giovane-sylvestrin/BMS_grs/Layout placa principal.pdf

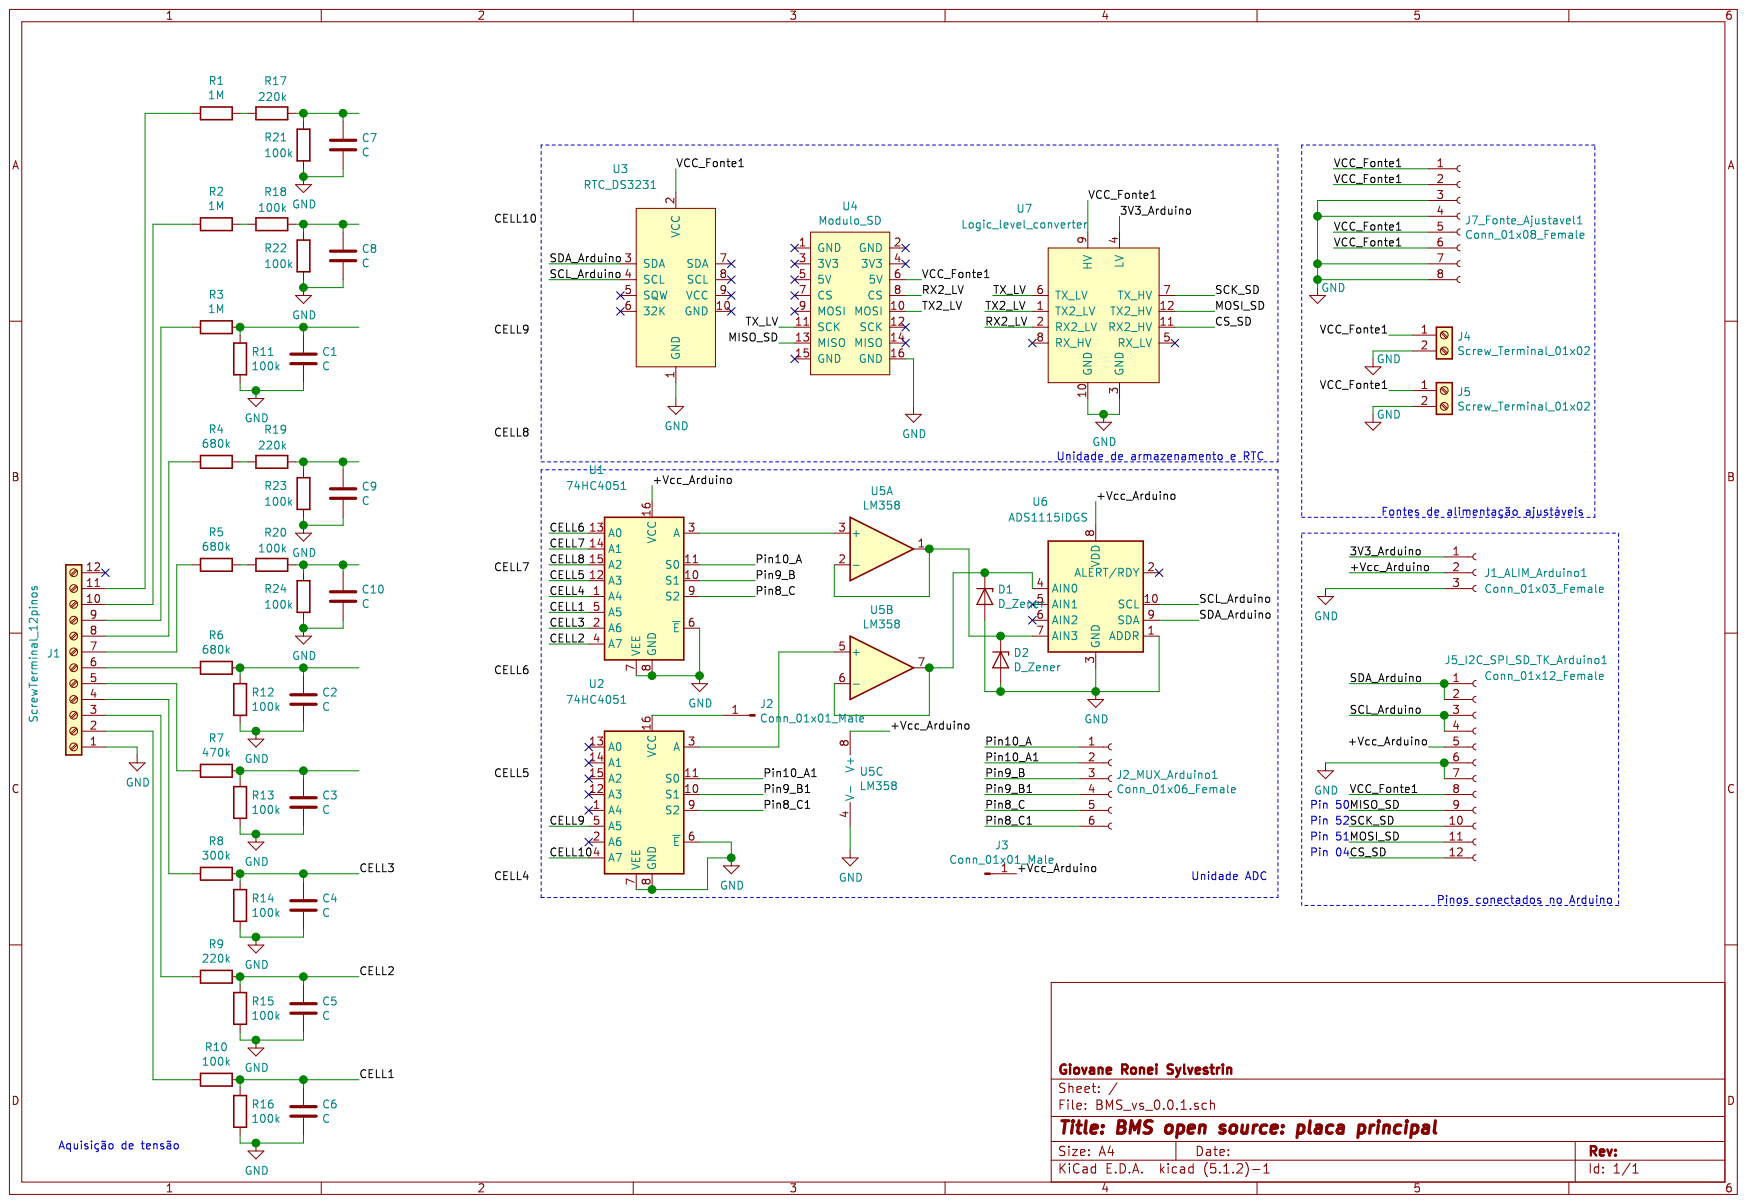
[picture p1: page 1]
