giovane-sylvestrin/BMS_grs/Layout placa temperatura.pdf

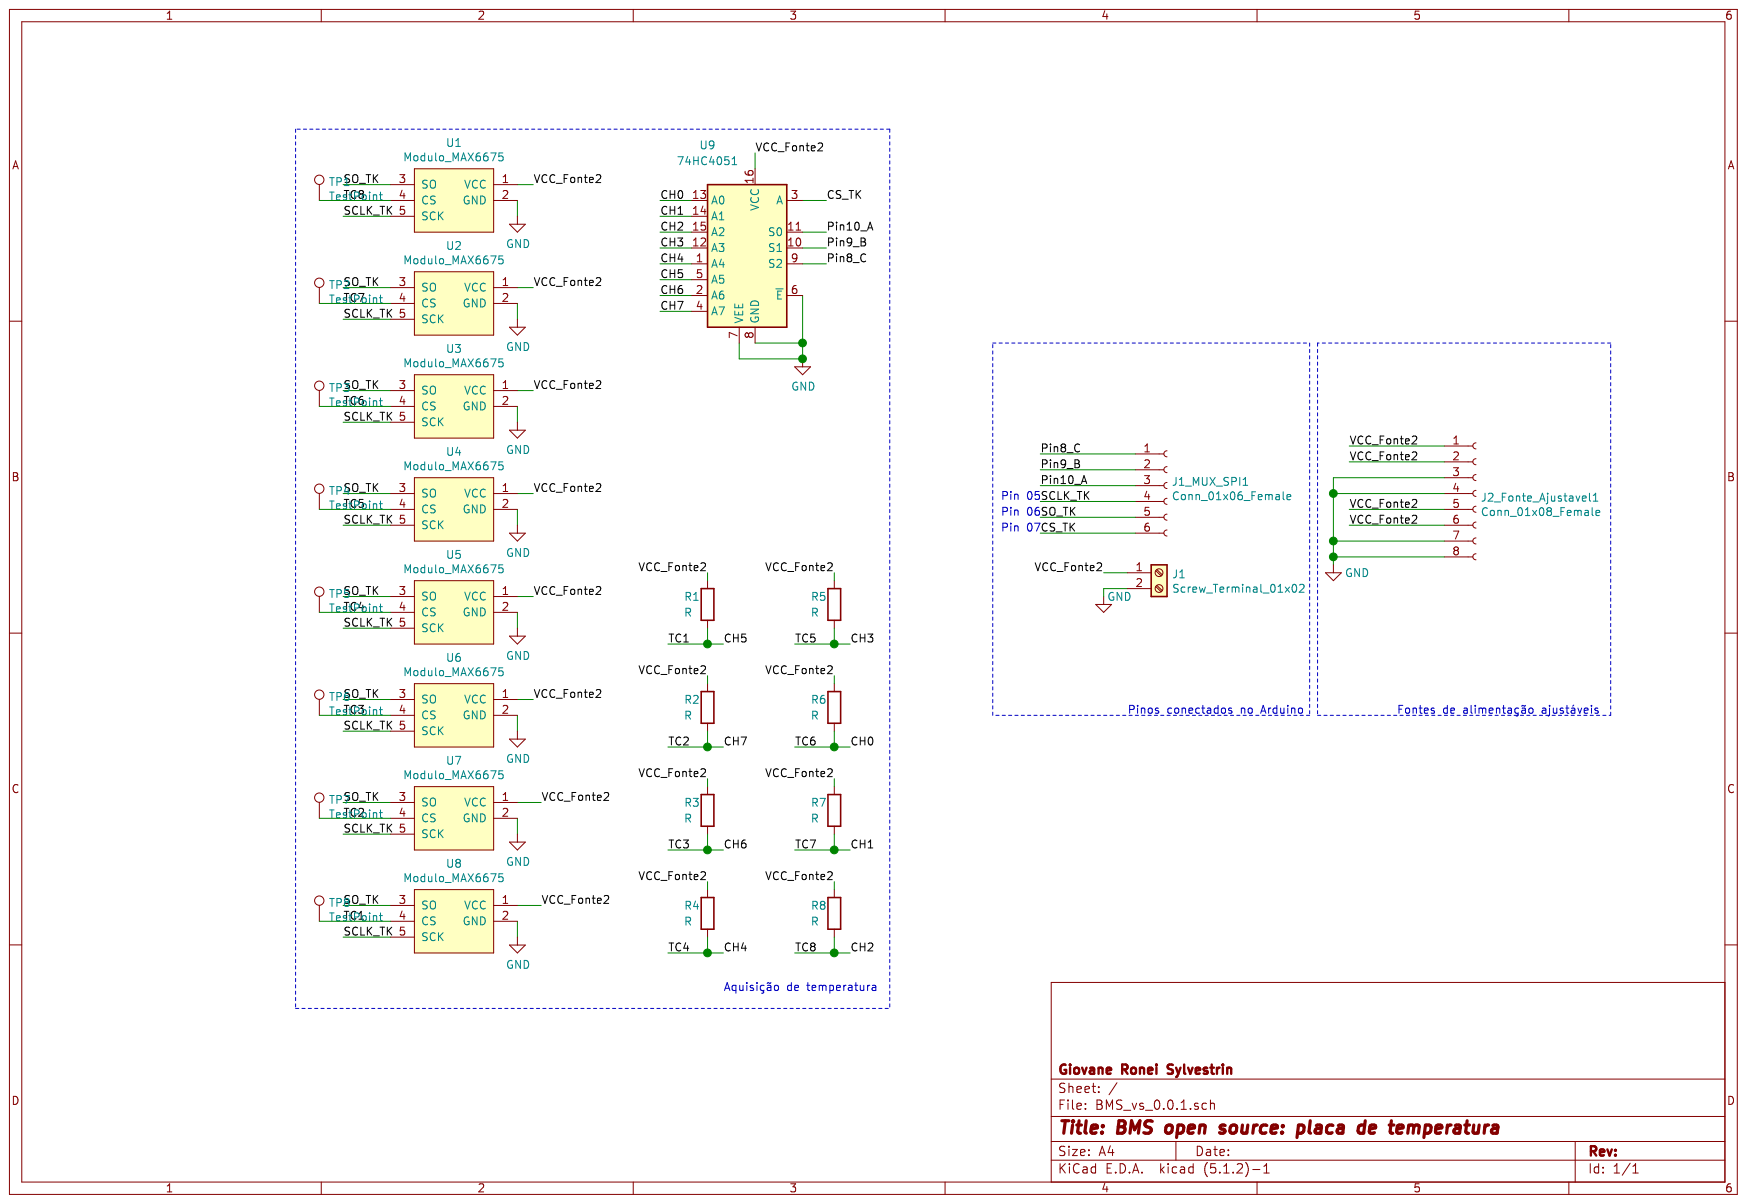
[picture p2: page 1]
