giovane-sylvestrin/BMS_grs/Algoritmos/apendice_sodio1AB/apendice_sodio1AB.ino

#include <Wire.h>  //Biblioteca para comunicação I2C
#include <DS3232RTC.h>  //Biblioteca RTC DS3231
#include <Streaming.h>  //Biblioteca para impressão de variáveis
#include <Time.h> //Biblioteca relacionada à manipulação de tempo
#include <SD.h> //Biblioteca para escrita e leitura cartão SD
#include <SPI.h>  //Biblioteca para comunicação SPI
#include <Adafruit_ADS1015.h> //Biblioteca para uso do ADC ADS1115

Adafruit_ADS1115 ads(0x48); //Endereçamento I2C do ADC para leitura dos canais de tensão
Adafruit_ADS1115 ads1(0x49); //Endereçamento I2C do ADC para leitura do sinal do ACS712

const int CS_PIN = 4; //Declaração do pino CS (chip select - SPI) no módulo SD

File file;  //Define "file" como comando para gravação de dados no cartão SD

//Definição dos pinos para manipulação do MUX nos canais de aquisição de tensão
int s0 = 10;
int s1 = 9;
int s2 = 8;

//Vetores de aquisição de tensão, tamanho do vetor indica número de canais habilitados
double AIN[8];
double v_lido[8];                              
double v_p[8];
double v_cell[8];

//Vaiáveis para aquisição de corrente
float corrente = 0;
float acs = 0;

//---------------- Temperatura ------------------------------------------------
const int SO = 6; //Definição pino MISO - Master Input, Slave Output - Para MAX6675
const int SCLK = 7; //Definição pino SCLK - Serial Clock line - Para MAX6675
const int CS1 = 5;  //Definição pino CS - Chip Select - Para MAX6675

double Temp[8]; //Vetor para aquisição de temperatura, tamanho do vetor indica número de canais habilitados 

//Definição dos pinos para manipulação do DEMUX nos canais de aquisição de temperatura
int A_t = 13;
int B_t = 12;
int C_t = 11;

byte SPImax(); //Declaração da função de comunicação SPI com MAX6675 por software
double leitura_termopar(int Selecao);

//-----------------------------------------------------------------------------

int intervalo = 2; //Tempo (em s) de amostragem das medidas (2s - 1 cell, 10 - multi)
int cont = 0; //Contador de amostras de medidas

int pausa = 5; //Pausa em us para alteração do canal do MUX/DEMUX

//----- Declaração variáveis SOC: EKF, contagem de Coulomb, e contagem modificada --------
float v_0; //Variável que recebe o valor de tensão do canal 1 (EKF aplicado)
float x_prevA = 0; //Estimação prévia do SOC Proposta A
float x_prevB = 0; //Estimação prévia do SOC Proposta B
float x_prev = 0;
float R_in = 0; //Resistência interna
float t_0 = 0;  //Variável para contagem de de tempo
float t_end = 0;  //Variável para contagem de de tempo
float t_end1 = 0; //Variável para contagem de de tempo
float x_0A = 100;  //Definição do SOC inicial e variável auxiliar na estimação SOC Proposta A
float x_0B = 100;  //Definição do SOC inicial e variável auxiliar na estimação SOC Proposta A
float ocv = 0;  //Tensão de circuito aberto
float C = 0;  //Parâmetro relacionado a mtriz jacobiana EKF (Eq. 4.14)
float C1 = 0; //Variável auxiliar para cálculo de C
float C2 = 0; //Variável auxiliar para cálculo de C
float Q = 0.001;  //Covariância associada ao ruído de estado
float R = 0.001;  //Covariância associada ao ruído do sensor
float L = 0;  //Ganho de Kalman
float P_prevA = 0; //Covariância do erro de estimação prévia Proposta A
float P_prevB = 0; //Covariância do erro de estimação prévia Proposta B
float P_0A = 10000; //Covariância do erro de estimação inicial e atualizado
float P_0B = 10000; //Covariância do erro de estimação inicial e atualizado
float y_prevA = 0; //Tensão terminal estimada Proposta A
float y_prevB = 0; //Tensão terminal estimada Proposta B
float x_posA = 0;  //SOC estimado atualizado Proposta A
float x_posB = 0;  //SOC estimado atualizado Proposta B
float x_posmxA = 0;  //Limite superior de estimação SOC (intervalo de confiança) Proposta A
float x_posmxB = 0;  //Limite superior de estimação SOC (intervalo de confiança) Proposta B
float x_posmiA = 0;  //Limite inferior de estimação SOC (intervalo de confiança) Proposta A
float x_posmiB = 0;  //Limite inferior de estimação SOC (intervalo de confiança) Proposta B
float x_cc = 100; //Definição do SOC inicial para a estimação por contagem de Coulomb
int s = 0;  //Define sinal da corrente (carga ou descarga)
int st = 0; //Define atualização na contagem de capacidade de carga(DODc) e descarga (DOD)
int estado = 1; //Define condição de uso do EKF na proposta A
int ref = 0;  //Variável auxiliar de contagem da proposta B
float DOD = 0; //Capacidade de descarga em Ah
float DODc = 0; //Capacidade de carga em Ah
//----------------------------------------------------------------------------------------

//Função de declaração e inicialização (função padrão Arduino)
void setup(){
 
 //Define os pinos de manipulação MUX/DEMUX como saída
 pinMode(s0,OUTPUT);
 pinMode(s1,OUTPUT);
 pinMode(s2,OUTPUT);
 pinMode(A_t,OUTPUT);
 pinMode(B_t,OUTPUT);
 pinMode(C_t,OUTPUT);

 //Define pinos relacionados ao MAX6675 como saída ou entrada 
 pinMode(CS1,OUTPUT);
 pinMode(SCLK,OUTPUT);
 pinMode(SO,INPUT);
 digitalWrite(CS1,HIGH);

 //Inicializa os vetores de medição de tensão e temperatura
 for(int i = 0; i<=7; i++){
    AIN[i] = 0;
    v_lido[i] = 0;
    Temp[i] = 0; 
 }
 
 Serial.begin(115200);  //Inicia comunicação serial na taxa de 115200 bits/segundo

 inicia_SD(); //Inicialização do módulo SD
 
 //Comando da biblioteca Time.h para executar sincronização com o RTC DS3231
 setSyncProvider(RTC.get); //RTC.get é função da biblioteca DS3231.h e retorna tempo atual
 Serial << F("RTC Sync"); //Imprime na tela confirmação de sincronização
 if (timeStatus() != timeSet) Serial << F(" FALHA!"); //Imprime na tela erro de sincronização
 Serial << endl;

  //Configuração da resolução e ganho no uso do ADS1115
  //                                                                 ADS1115
  //Ganho ADC para aquisição de tensão                               -------
  //ads.setGain(GAIN_TWOTHIRDS);   // 2/3x ganho +/- 6.144V  1 bit = 0.1875mV 
  ads.setGain(GAIN_ONE);           // 1x ganho   +/- 4.096V  1 bit = 0.125mV 
  // ads.setGain(GAIN_TWO);        // 2x ganho   +/- 2.048V  1 bit = 0.0625mV
  // ads.setGain(GAIN_FOUR);       // 4x ganho   +/- 1.024V  1 bit = 0.03125mV
  // ads.setGain(GAIN_EIGHT);      // 8x ganho   +/- 0.512V  1 bit = 0.015625mV 
  // ads.setGain(GAIN_SIXTEEN);    // 16x ganho  +/- 0.256V  1 bit = 0.0078125mV

  ads1.setGain(GAIN_TWOTHIRDS); //Ganho ADC do sensor de corrente ACS712
  
  ads.begin();  //Início da operação do ADC de aquisição de tensão
  ads1.begin(); //Início da operação do ADC do sensor ACS712

  Serial.println("Iniciando monitoramento ...");
}

//Função de repetição do Arduíno
void loop(){

  time_t t; //Variável tipo time (32 bits): número de segundos desde 1970  
  tmElements_t tm;  //Estrutura para manipulação de tempo

    //Configuração de data e hora por entrada serial
    //Formato reconhecido: ANO,MES,DIA,HORA,MINUTO,SEGUNDO
    if (Serial.available() >= 12) { //Verifica se existe alteração na data/hora via serial

        int y = Serial.parseInt();
        if (y >= 100 && y < 1000){
            Serial << F("Erro: Ano deve ter 2 ou 4 digitos") << endl;
        }else{
            if (y >= 1000)
                tm.Year = CalendarYrToTm(y);
            else
            tm.Year = y2kYearToTm(y);
            tm.Month = Serial.parseInt();
            tm.Day = Serial.parseInt();
            tm.Hour = Serial.parseInt();
            tm.Minute = Serial.parseInt();
            tm.Second = Serial.parseInt();
            t = makeTime(tm); //t recebe a data e hora da estrutura tm em segundos
            RTC.set(t); //Configura a data e hora do RTC para corresponder a t
            setTime(t); //Define a hora atual baseada em t
            Serial << F("RTC configurado para: ");
            printDateTime(t); //Imprime na tela data e hora configurada
            Serial << endl;
            while (Serial.available() > 0) Serial.read(); //Ignora qualquer entrada serial distinta da desejada
        }
    }

    monitoramento(t); //Função principal de Monitoramento: tensão, corrente, temperatura e SOC
       
}

//Função para aquisição de tensão, corrente, temperatura
//Estimação SOC
//Gravação de Dados
//Comunicação Serial
void monitoramento(time_t t){

  t_0 = millis();
  
  int16_t adc3; //Variavel associada à leitura de tensão ADS1115
  time_t anterior; //Variável auxiiar no tempo de amostragem
  time_t atual; //Variável auxiliar no tempo de amostragem
  anterior = now(); //Recebe tempo atual
  atual = now();  //Recebe tempo atual

  //Laço de repetição para amostragem dos sinais de tensão, corrente e temperatura
  while(abs(atual-anterior) < intervalo)
  {
    //CÉLULA 1
    digitalWrite(s0,HIGH);
    digitalWrite(s1,LOW); //Seleção do canal do MUX CD4051
    digitalWrite(s2,HIGH);

    delayMicroseconds(pausa);
    
    adc3 = ads.readADC_SingleEnded(3);
    v_lido[0] = (adc3*0.125)/1000;
    AIN[0] = AIN[0] + v_lido[0];

    //Para habilitar demais canais de tensão, retirar comentário
    /*
    //CÉLULA 2
    digitalWrite(s0,HIGH);
    digitalWrite(s1,HIGH);
    digitalWrite(s2,HIGH);

    delayMicroseconds(pausa);
    
    adc3 = ads.readADC_SingleEnded(3);
    v_lido[1] = (adc3*0.125)/1000;
    AIN[1] = AIN[1] + v_lido[1];
    
    //CÉLULA 3
    digitalWrite(s0,LOW);
    digitalWrite(s1,HIGH);
    digitalWrite(s2,HIGH);

    delayMicroseconds(pausa);
    
    adc3 = ads.readADC_SingleEnded(3);
    v_lido[2] = (adc3*0.125)/1000;
    AIN[2] = AIN[2] + v_lido[2];
    
    //CÉLULA 4
    digitalWrite(s0,LOW);
    digitalWrite(s1,LOW);
    digitalWrite(s2,HIGH);

    delayMicroseconds(pausa);
    
    adc3 = ads.readADC_SingleEnded(3);
    v_lido[3] = (adc3*0.125)/1000;
    AIN[3] = AIN[3] + v_lido[3];

    //CÉLULA 5
    digitalWrite(s0,HIGH);
    digitalWrite(s1,HIGH);
    digitalWrite(s2,LOW);

    delayMicroseconds(pausa);
    
    adc3 = ads.readADC_SingleEnded(3);
    v_lido[4] = (adc3*0.125)/1000;
    AIN[4] = AIN[4] + v_lido[4];

    //CÉLULA 6
    digitalWrite(s0,LOW);
    digitalWrite(s1,LOW);
    digitalWrite(s2,LOW);

    delayMicroseconds(pausa);
    
    adc3 = ads.readADC_SingleEnded(3);
    v_lido[5] = (adc3*0.125)/1000;
    AIN[5] = AIN[5] + v_lido[5];

    //CÉLULA 7
    digitalWrite(s0,HIGH);
    digitalWrite(s1,LOW);
    digitalWrite(s2,LOW);

    delayMicroseconds(pausa);
    
    adc3 = ads.readADC_SingleEnded(3);
    v_lido[6] = (adc3*0.125)/1000;
    AIN[6] = AIN[6] + v_lido[6];

    //CÉLULA 8
    digitalWrite(s0,LOW);
    digitalWrite(s1,HIGH);
    digitalWrite(s2,LOW);

    delayMicroseconds(pausa);
    
    adc3 = ads.readADC_SingleEnded(3);
    v_lido[7] = (adc3*0.125)/1000;
    AIN[7] = AIN[7] + v_lido[7];

    delayMicroseconds(pausa);
    */
    
    acs = acs + ads1.readADC_SingleEnded(3); //Leitura sinal sensor de corrente ACS712
    
    //Para habilitar aquisição de temperatura, retirar comentário
    //temperatura(); //Função de aquisição de temperatura
        
    cont = cont +1;
    atual = now();
    
   }

  //Conversão do sinal de entrada do ADC para valores de tensão
  AIN[0] = AIN[0]/cont;
  v_p[0] = 2*AIN[0];

  AIN[1] = AIN[1]/cont;
  v_p[1] = 3.195*AIN[1];

  AIN[2] = AIN[2]/cont;
  v_p[2] = 4.019*AIN[2];

  AIN[3] = AIN[3]/cont;
  v_p[3] = 5.7296*AIN[3];

  AIN[4] = AIN[4]/cont;
  v_p[4] = 7.9203*AIN[4];

  AIN[5] = AIN[5]/cont;
  v_p[5] = 8.9333*AIN[5];

  AIN[6] = AIN[6]/cont;
  v_p[6] = 10.0268*AIN[6];

  AIN[7] = AIN[7]/cont;
  v_p[7] = 11.1652*AIN[7];

  //Estabelece a tensão terminal em cada canal de aquisição
  for(int i = 0; i <= 7; i++){
    if(v_p[i] < 0.1){
      v_p[i] = 0;
      v_cell[i] = 0;
    }else{
      v_cell[i] = v_p[i];
      if(i>0){
        for(int j = 0; j<i; j++){
          v_cell[i] = v_cell[i] - v_cell[j];
        }
      }
    }
  }

  //Estabelece a temperatura por canal
  for(int i = 0; i <= 7; i++){
    Temp[i] = Temp[i]/cont;
  }

  //Estabelece o valor de corrente em A
  acs = acs/cont;
  acs = (acs*0.1875)/1000;
  corrente = ((acs - 2.51)*1000)/66;

  //Define se a corrente é no sentido carga ou descarga
  if(corrente < 0)                  
  {
    s=1; //descarga
  }else{
    s=-1; //carga
  }

  //Calibração do sinal de corrente
  corrente = s*(0.96444433*abs(corrente) + 0.00092722); 
  
  if(abs(corrente)<0.2) //Descarta possíveis ruídos de medição
  {
    corrente = 0;
  }
  
  v_0 = v_cell[0];  //Tensão canal 1 habilitada para a estimativa SOC via EKF
    
  //------------------------- DESCARGA/REPOUSO -----------------------------
  if((v_0 > 1) && (corrente >= 0))
    {
      //Função responsável pela estimação do SOC na descarga via: EKF, contagem de Coulomb e contagem modificada
      EKF();
    }
  //----------------------------- CARGA ------------------------------------
  if(corrente < 0)
    {
      //Função responsável pela estimação do SOC na descarga: contagem de Coulomb
      Coulomb_carga(); 
    }
  //------------------------------------------------------------------------  
  t = now();
  //printDateTime(t); //Habilitar caso usuário não use interface Node-RED
  
  //Envio dos resultados por comunicação serial
  Serial.print("{\"V1\":");
  Serial.print(v_cell[0],4);
  Serial.print(",\"I\":");
  Serial.print(corrente,3);
  Serial.print(",\"x_posA\":");
  Serial.print(x_posA);
  Serial.print(",\"x_mxA\":");
  Serial.print(x_posmxA);
  Serial.print(",\"x_mnA\":");
  Serial.print(x_posmiA);
  Serial.print(",\"x_posB\":");
  Serial.print(x_posB);
  Serial.print(",\"x_mxB\":");
  Serial.print(x_posmxB);
  Serial.print(",\"x_mnB\":");
  Serial.print(x_posmiB);
  Serial.print(",\"x_cc\":");
  Serial.print(x_cc);
  Serial.print(",\"DOD_d\":");
  Serial.print(DOD);
  Serial.print(",\"DOD_c\":");
  Serial.print(DODc);
  Serial.print(",\"y_ekfA\":");
  Serial.print(y_prevA,4);
  Serial.print(",\"y_ekfB\":");
  Serial.print(y_prevB,4);
  Serial.print(",\"delta_t\":");
  Serial.print(abs(t_0 - t_end1));
  Serial.println("}");
  
  abre_arquivo("DADOS.txt");  //Abre (ou cria) arquivo de texto DADOS.txt no cartão SD
  
  grava_tempo(t); //Grava data e hora no cartão SD
  //Dados gravados no cartão SD
  //Dados BMS unicelular com EKF
  file.print(" ADC1: ");
  file.print(AIN[0],4);
  file.print(" Ponto A: ");
  file.print(v_p[0],4);
  file.print(" V1: ");
  file.print(v_0,4);
  file.print(" VekfA: ");
  file.print(y_prevA,4);
  file.print(" SOCA: ");
  file.print(x_posA,4);
  file.print(" ");
  file.print(x_posmxA,4);
  file.print(" ");
  file.print(x_posmiA,4);
  file.print(" VekfB: ");
  file.print(y_prevB,4);
  file.print(" SOCB: ");
  file.print(x_posB,4);
  file.print(" ");
  file.print(x_posmxB,4);
  file.print(" ");
  file.print(x_posmiB,4);
  file.print(" SOCcc: ");
  file.print(x_cc,4);
  file.print(" DODd (Ah): ");
  file.print(DOD);
  file.print(" DODc (Ah): ");
  file.print(DODc);
  file.print(" delta_t (ms): ");
  file.print(abs(t_0 - t_end1));
  file.print("\tI(A): ");
  file.println(corrente,3);

  fecha_arquivo();  //Fecha arquivo DADOS.txt

  //Reinicia variáves
  for(int i = 0; i<=7; i++){
    AIN[i] = 0;
    v_lido[i] = 0;
    Temp[i] = 0; 
  }
  
  acs = 0;
  cont = 0; 
}

//Função de inicialização do cartão SD
void inicia_SD()
{
  pinMode(CS_PIN, OUTPUT); //Define o pino CS_PIN como saída
  //Verifica se o cartão SD está presente
  if (SD.begin()){
    
  }else{
    Serial.println("Erro no cartao"); //Mensagem de erro
    return;
  }
}

//Função para abrir/criar arquivo de gravação
int abre_arquivo(char filename[])
{
  file = SD.open(filename, FILE_WRITE);
  //Verifica se existe erro no arquivo
  if(file)
  {
    return 1;
  }else{
    Serial.println("Erro na gravacao"); //Mensagem de erro
    return 0;
  }
}

//Função para fechar arquivo de gravação
void fecha_arquivo()
{
  if (file)
  {
    file.close();
  }
}

//Função para gravar data e hora no arquivo do cartão SD
void grava_tempo(time_t t)
 {
   file.print(day(t));
   file.print("/");
   if (month(t) < 10)
   {
     file.print("0");
   }
   file.print(month(t));
   file.print("/");
   file.print(year(t));
   file.print(" Hora: ");
   if (hour(t) < 10)
   {
     file.print("0");
   }
   file.print(hour(t));
   file.print(":");
   if (minute(t) < 10)
   {
     file.print("0");
   }
   file.print(minute(t));
   file.print(":");
   if (second(t) < 10)
   {
     file.print("0");
   }
   file.print(second(t)); 
  }
  
//Função que imprime data e hora na serial
void printDateTime(time_t t)
{
    printDate(t); //Data
    Serial << ' ';
    printTime(t); //Hora
}

//Função que define formato de impressão da hora
void printTime(time_t t)
{
    printI00(hour(t), ':');
    printI00(minute(t), ':');
    printI00(second(t), ' ');
}

//Função que define formato de impressão da data
void printDate(time_t t)
{
    printI00(day(t), 0);
    Serial << monthShortStr(month(t)) << _DEC(year(t));
}

//Função auxiliar na impressão de hora, substitui "0" por "00"
void printI00(int val, char delim)
{
    if (val < 10) Serial << '0';
    Serial << _DEC(val);
    if (delim > 0) Serial << delim;
    return;
}

//Função para aquisição de temperatura
void temperatura(){
    
    //SENSOR 1
    digitalWrite(A_t,HIGH);
    digitalWrite(B_t,LOW);  //Definição do canal do DEMUX CD4051
    digitalWrite(C_t,HIGH);
    
    delayMicroseconds(5);
    
    Temp[0] = Temp[0] + leitura_termopar(CS1);
  
    //SENSOR 2
    digitalWrite(A_t,HIGH);
    digitalWrite(B_t,HIGH);
    digitalWrite(C_t,HIGH);
    
    delayMicroseconds(5);
    
    Temp[1] = Temp[1] + leitura_termopar(CS1);
   
    //SENSOR 3
    digitalWrite(A_t,LOW);
    digitalWrite(B_t,HIGH);
    digitalWrite(C_t,HIGH);
  
    delayMicroseconds(5);
  
    Temp[2] = Temp[2] + leitura_termopar(CS1);
  
    //SENSOR 4
    digitalWrite(A_t,LOW);
    digitalWrite(B_t,LOW);
    digitalWrite(C_t,HIGH);
  
    delayMicroseconds(5);
  
    Temp[3] = Temp[3] + leitura_termopar(CS1);

    //SENSOR 5
    digitalWrite(A_t,LOW);
    digitalWrite(B_t,HIGH);
    digitalWrite(C_t,LOW);
  
    delayMicroseconds(5);
  
    Temp[4] = Temp[4] + leitura_termopar(CS1);

    //SENSOR 6
    digitalWrite(A_t,HIGH);
    digitalWrite(B_t,LOW);
    digitalWrite(C_t,LOW);
  
    delayMicroseconds(5);
  
    Temp[5] = Temp[5] + leitura_termopar(CS1);

    //SENSOR 7
    digitalWrite(A_t,LOW);
    digitalWrite(B_t,LOW);
    digitalWrite(C_t,LOW);
  
    delayMicroseconds(5);
  
    Temp[6] = Temp[6] + leitura_termopar(CS1);

    //SENSOR 8
    digitalWrite(A_t,HIGH);
    digitalWrite(B_t,HIGH);
    digitalWrite(C_t,LOW);
  
    delayMicroseconds(5);
  
    Temp[7] = Temp[7] + leitura_termopar(CS1);
    
}

//Função para leitura de temperatura MAX6675
double leitura_termopar(int Selecao) {
  uint16_t max_temp;  //Declara variável de 16 bits que recebe os bits lidos na porta SO
  digitalWrite(Selecao, LOW); //Inicia transmissão de dados
  delay(1);
  max_temp = SPImax();  //Recebe a leitura dos 8 primeiros bits lidos pela função SPImax
  max_temp <<= 8; //Desloca 8 posições para a esquerda: D15-D8
  max_temp |= SPImax(); //Recebe a leitura dos 8 últimos bits lidos pela função SPImax - D7-D0
  digitalWrite(Selecao, HIGH); //Finaliza transmissão de dados
 
  //Verifica se o termpopar esta conectado: bit 2 (D2) deve ser igual a 4
  if (max_temp & 0x4) {
    return NAN; //Caso não conectado retorna NAN
  }
  max_temp >>= 3; //Desloca para a direita os 3 primeiros bits, eliminando-os, leitura vai de D3 até D14
  return max_temp*0.25; //Coverte leitura pela resolução do MAX6675
}

//Função para cmunicação SPI MAX6675 – leitura dos bits na saída SO (1 byte – 8 bits)
byte SPImax(void) {
  int i;
  byte d_temp = 0; //Variável byte que vai armazenar a leitura
 
  //Laço para ler 8 bits de cada vez
  for (i = 7; i >= 0; i--)    
  {
    digitalWrite(SCLK, LOW);  //Início do clock (SCK)
    delay(1);
    if (digitalRead(SO)) {  //Leitura dos dados da porta SO do MAX6675
      d_temp |= (1 << i); //Armazena os bits, 0 ou 1,deslocando para esquerda até formar o byte
    }
    digitalWrite(SCLK, HIGH); //Fim do clock (SCK)
    delay(1);
  }
  return d_temp;  //Retorna o byte de leitura do MAX6675
}

//Função que implementa o EKF, contagem modificada, e contagem de Coulomb (DESCARGA/REPOUSO)
void EKF(){

    //ref indica se SOC da bateria esta sendo calculado em:
    //carga (0), repouso (1), EKF (2), EKF proposta B (3)
    //Valores são gravados no cartão SD para análise posterior, definindo o % de estimação usando proposta B
    if(corrente == 0)
    {
      ref = 1;   
    }else{
      ref = 2;
    }
  
    if(x_0A = 100) //Se SOC inicial for 100%, EKF esta habilitado
    {
      estado = 1;
    }

    if((corrente == 0) && (x_0A<100)) //Se SOC inicial for 100%, EKF esta habilitado
    {
      estado = 0;
    }
    
    t_end = millis();
    //Estimação previa SOC: primeira equação do modelo (contagem de Coulomb)
    x_prevA = x_0A - ((abs(t_end - t_0)+abs(t_0 - t_end1))/3.6e06)*(corrente/38)*100;
    x_prevB = x_0B - ((abs(t_end - t_0)+abs(t_0 - t_end1))/3.6e06)*(corrente/38)*100;
    //Estimação SOC por contagem de Coulomb
    x_cc = x_cc - ((abs(t_end - t_0)+abs(t_0 - t_end1))/3.6e06)*(corrente/38)*100;

    if((st==0) && (corrente>0)) //Redefine parâmetros após carga
    {
      DOD = 0; //Capacidade de descarga reiniciada após processo de carga (st==0)
      P_0A = 10000; //Todo o inicio de descarga a covariancia do erro é reiniciada no maximo
      P_0B = 10000;
      st=1; //Carrega informação do processo atual de descarga
    }
    //Calcula Ah descarregado
    DOD = DOD + ((abs(t_end - t_0)+abs(t_0 - t_end1))/3.6e06)*corrente;
    t_end1 = millis();
    
    //Limita SOC previo na faixa 0%-100%
    if(x_prev>100)
      {
        x_prevA = 100;
        x_prevB = 100;
      }
    
    if(x_prev<0)
      {
        x_prevA = 0;
        x_prevB = 0;
      }
     //----------------------------------- PROPOSTA A ------------------------------------------------------------------
    //-------------------------------- Cálculo da Resistencia interna -------------------------------------------------- 
    //Rin em função do SOC prévio e corrente medida
    x_prev = x_prevA;
    if(x_prev<=4)
    {
        if(corrente>5.2){
          R_in = 0.04853 + (-0.00505)*((x_prev-2.709)/0.7584) + 0.002539*((corrente-6.752)/1.416) + (-0.001252)*pow(((x_prev-2.709)/0.7584),2) + (-0.003083)*((x_prev-2.709)/0.7584)*((corrente-6.752)/1.416) + 0.000267*pow(((corrente-6.752)/1.416),2) + 0.001197*pow(((x_prev-2.709)/0.7584),3) + 0.001032*pow(((x_prev-2.709)/0.7584),2)*((corrente-6.752)/1.416) + 0.0004252*((x_prev-2.709)/0.7584)*pow(((corrente-6.752)/1.416),2) + (-0.001797)*pow(((corrente-6.752)/1.416),3) + 0.0006883*pow(((x_prev-2.709)/0.7584),4) + 0.001825*pow(((x_prev-2.709)/0.7584),3)*((corrente-6.752)/1.416) + 0.001299*pow(((x_prev-2.709)/0.7584),2)*pow(((corrente-6.752)/1.416),2) + 0.0008473*((x_prev-2.709)/0.7584)*pow(((corrente-6.752)/1.416),3) + (-0.0003871)*pow(((x_prev-2.709)/0.7584),5) + (-0.0008726)*pow(((x_prev-2.709)/0.7584),4)*((corrente-6.752)/1.416) + (-0.0008458)*pow(((x_prev-2.709)/0.7584),3)*pow(((corrente-6.752)/1.416),2) + (-0.0004691)*pow(((x_prev-2.709)/0.7584),2)*pow(((corrente-6.752)/1.416),3);     
        }
        if(corrente<4.8){
          R_in = 0.03703 + (-0.001523)*((x_prev-2.015)/1.163) + 0.0003423*((corrente-4.183)/0.384) + 0.0008378*pow(((x_prev-2.015)/1.163),2) + (-8.558e-05)*((x_prev-2.015)/1.163)*((corrente-4.183)/0.384) + 0.001394*pow(((corrente-4.183)/0.384),2) + (-0.0007461)*pow(((x_prev-2.015)/1.163),3) + (-2.369e-05)*pow(((x_prev-2.015)/1.163),2)*((corrente-4.183)/0.384) + (-0.0005578)*((x_prev-2.015)/1.163)*pow(((corrente-4.183)/0.384),2) + (-0.0002139)*pow(((x_prev-2.015)/1.163),4) + (9.475e-08)*pow(((x_prev-2.015)/1.163),3)*((corrente-4.183)/0.384) + 0.0001958*pow(((x_prev-2.015)/1.163),2)*pow(((corrente-4.183)/0.384),2) + 0.0002165*pow(((x_prev-2.015)/1.163),5) + (3.401e-06)*pow(((x_prev-2.015)/1.163),4)*((corrente-4.183)/0.384) + (-1.072e-05)*pow(((x_prev-2.015)/1.163),3)*pow(((corrente-4.183)/0.384),2);
        }
        if(corrente>=4.8 && corrente<=5.2){
          R_in = 0.04316 + (-0.00304)*((x_prev-2.274)/1.082) + 0.004703*((corrente-4.957)/0.3148) + 0.00569*pow(((x_prev-2.274)/1.082),2) + (-0.000955)*((x_prev-2.274)/1.082)*((corrente-4.957)/0.3148) + (-0.00886)*pow(((x_prev-2.274)/1.082),3) + 0.006438*pow(((x_prev-2.274)/1.082),2)*((corrente-4.957)/0.3148) + 0.003353*pow(((x_prev-2.274)/1.082),4) + (-0.01107)*pow(((x_prev-2.274)/1.082),3)*((corrente-4.957)/0.3148) + (7.194e-05)*pow(((x_prev-2.274)/1.082),5) + 0.004513*pow(((x_prev-2.274)/1.082),4)*((corrente-4.957)/0.3148);
        }
    }
 
    if(x_prev>4 && x_prev<=9)
    {
        if(corrente>5.2){
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
    }

    if(x_prev<=12.85)
    {
        C2 = 9*(1/3.712)*0.006391*pow(((x_prev-6.415)/3.712),8) + 8*(1/3.712)*0.009434*pow(((x_prev-6.415)/3.712),7) + 7*(1/3.712)*(-0.03024)*pow(((x_prev-6.415)/3.712),6) + 6*(1/3.712)*(-0.04723)*pow(((x_prev-6.415)/3.712),5) + 5*(1/3.712)*0.03629*pow(((x_prev-6.415)/3.712),4) + 4*(1/3.712)*0.06931*pow(((x_prev-6.415)/3.712),3) + 3*(1/3.712)*0.008763*pow(((x_prev-6.415)/3.712),2) + 2*(1/3.712)*(-0.002912)*((x_prev-6.415)/3.712) + (1/3.712)*0.02003;
    }
   
    if(x_prev>12.85)
    {
        C2 = 8*(1/24.77)*0.0001792*pow(((x_prev-56.24)/24.77),7) + 7*(1/24.77)*(-0.0003101)*pow(((x_prev-56.24)/24.77),6) + 6*(1/24.77)*(-0.001027)*pow(((x_prev-56.24)/24.77),5) + 5*(1/24.77)*0.00225*pow(((x_prev-56.24)/24.77),4) + 4*(1/24.77)*0.001846*pow(((x_prev-56.24)/24.77),3) + 3*(1/24.77)*(-0.005562)*pow(((x_prev-56.24)/24.77),2) + 2*(1/24.77)*(-0.0002777)*((x_prev-56.24)/24.77) + (1/24.77)*0.006952;
    }  
    
    C = C2-C1*corrente;
    //-------------------------------------------------------------------------------------------------------------------
    y_prevA = ocv - R_in*corrente; //Tensão terminal estimada a partir do SOC prévio
    
    //Alterações da Proposta A quando às covariãncias Q e R em função do desvio de tensão do modelo
    if((corrente>0)&&(abs(v_0-y_prevA)>0.002)&&(P_0A<1))
    {
      Q = 0.0001;
      R = 0.01;

      if(abs(v_0-y_prevA)>0.01)
      {
        R = 0.1;
      } 
    }else{
      Q = 0.001;
      R = 0.001;
    }
            
    P_prevA = 1*P_0A*1+Q; //Covariância do erro na estimativa a priori do estado
    
    L = (P_prevA*C)/(C*P_prevA*C+R); //Ganho de Kalman

    //Atualização do estado estimado   
    x_posA = x_prevA + ((P_prevA*C)/(C*P_prevA*C+R))*(v_0 - y_prevA);

    if(x_posA>100)
      {
        x_posA = 100;
      }

    if(x_posA<0)
      {
        x_posA = 0;
      }

    //Atualização da covariância do erro de estimativa
    P_0A = (1-L*C)*P_prevA*(1-L*C)+L*R*L;

    //Alteração proposta A
    if((corrente>0)&&(abs(v_0-y_prevA)>0.25))
    {
      P_0A = 10000;
    }
    
    //Se a variavel estado não indicar que a bateria sofreu uma carga completa antes da atual descarga
    //EKF não atualizado (recebe Contagem de Coulomb)
    if(estado == 0)
    {
      x_posA = x_prevA;
    }
    
    //Cálcula intervalo de confiança e adiciona à estimativa EKF 
    x_posmxA = x_posA + 10*sqrt(P_0A);
    x_posmiA = x_posA - 10*sqrt(P_0A);  
    
    //Atualiza SOC inicial para próximo passo 
    x_0A = x_posA;
    //----------------------------------------------------------------------------------------------
    
    //-------------------------------------------- PROPOSTA B --------------------------------------
    //-------------------------------- Cálculo da Resistencia interna -------------------------------------------------- 
    //Rin em função do SOC prévio e corrente medida
    x_prev = x_prevB;
    if(x_prev<=4)
    {
        if(corrente>5.2){
          R_in = 0.04853 + (-0.00505)*((x_prev-2.709)/0.7584) + 0.002539*((corrente-6.752)/1.416) + (-0.001252)*pow(((x_prev-2.709)/0.7584),2) + (-0.003083)*((x_prev-2.709)/0.7584)*((corrente-6.752)/1.416) + 0.000267*pow(((corrente-6.752)/1.416),2) + 0.001197*pow(((x_prev-2.709)/0.7584),3) + 0.001032*pow(((x_prev-2.709)/0.7584),2)*((corrente-6.752)/1.416) + 0.0004252*((x_prev-2.709)/0.7584)*pow(((corrente-6.752)/1.416),2) + (-0.001797)*pow(((corrente-6.752)/1.416),3) + 0.0006883*pow(((x_prev-2.709)/0.7584),4) + 0.001825*pow(((x_prev-2.709)/0.7584),3)*((corrente-6.752)/1.416) + 0.001299*pow(((x_prev-2.709)/0.7584),2)*pow(((corrente-6.752)/1.416),2) + 0.0008473*((x_prev-2.709)/0.7584)*pow(((corrente-6.752)/1.416),3) + (-0.0003871)*pow(((x_prev-2.709)/0.7584),5) + (-0.0008726)*pow(((x_prev-2.709)/0.7584),4)*((corrente-6.752)/1.416) + (-0.0008458)*pow(((x_prev-2.709)/0.7584),3)*pow(((corrente-6.752)/1.416),2) + (-0.0004691)*pow(((x_prev-2.709)/0.7584),2)*pow(((corrente-6.752)/1.416),3);     
        }
        if(corrente<4.8){
          R_in = 0.03703 + (-0.001523)*((x_prev-2.015)/1.163) + 0.0003423*((corrente-4.183)/0.384) + 0.0008378*pow(((x_prev-2.015)/1.163),2) + (-8.558e-05)*((x_prev-2.015)/1.163)*((corrente-4.183)/0.384) + 0.001394*pow(((corrente-4.183)/0.384),2) + (-0.0007461)*pow(((x_prev-2.015)/1.163),3) + (-2.369e-05)*pow(((x_prev-2.015)/1.163),2)*((corrente-4.183)/0.384) + (-0.0005578)*((x_prev-2.015)/1.163)*pow(((corrente-4.183)/0.384),2) + (-0.0002139)*pow(((x_prev-2.015)/1.163),4) + (9.475e-08)*pow(((x_prev-2.015)/1.163),3)*((corrente-4.183)/0.384) + 0.0001958*pow(((x_prev-2.015)/1.163),2)*pow(((corrente-4.183)/0.384),2) + 0.0002165*pow(((x_prev-2.015)/1.163),5) + (3.401e-06)*pow(((x_prev-2.015)/1.163),4)*((corrente-4.183)/0.384) + (-1.072e-05)*pow(((x_prev-2.015)/1.163),3)*pow(((corrente-4.183)/0.384),2);
        }
        if(corrente>=4.8 && corrente<=5.2){
          R_in = 0.04316 + (-0.00304)*((x_prev-2.274)/1.082) + 0.004703*((corrente-4.957)/0.3148) + 0.00569*pow(((x_prev-2.274)/1.082),2) + (-0.000955)*((x_prev-2.274)/1.082)*((corrente-4.957)/0.3148) + (-0.00886)*pow(((x_prev-2.274)/1.082),3) + 0.006438*pow(((x_prev-2.274)/1.082),2)*((corrente-4.957)/0.3148) + 0.003353*pow(((x_prev-2.274)/1.082),4) + (-0.01107)*pow(((x_prev-2.274)/1.082),3)*((corrente-4.957)/0.3148) + (7.194e-05)*pow(((x_prev-2.274)/1.082),5) + 0.004513*pow(((x_prev-2.274)/1.082),4)*((corrente-4.957)/0.3148);
        }
    }
 
    if(x_prev>4 && x_prev<=9)
    {
        if(corrente>5.2){
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
    }

    if(x_prev<=12.85)
    {
        C2 = 9*(1/3.712)*0.006391*pow(((x_prev-6.415)/3.712),8) + 8*(1/3.712)*0.009434*pow(((x_prev-6.415)/3.712),7) + 7*(1/3.712)*(-0.03024)*pow(((x_prev-6.415)/3.712),6) + 6*(1/3.712)*(-0.04723)*pow(((x_prev-6.415)/3.712),5) + 5*(1/3.712)*0.03629*pow(((x_prev-6.415)/3.712),4) + 4*(1/3.712)*0.06931*pow(((x_prev-6.415)/3.712),3) + 3*(1/3.712)*0.008763*pow(((x_prev-6.415)/3.712),2) + 2*(1/3.712)*(-0.002912)*((x_prev-6.415)/3.712) + (1/3.712)*0.02003;
    }
   
    if(x_prev>12.85)
    {
        C2 = 8*(1/24.77)*0.0001792*pow(((x_prev-56.24)/24.77),7) + 7*(1/24.77)*(-0.0003101)*pow(((x_prev-56.24)/24.77),6) + 6*(1/24.77)*(-0.001027)*pow(((x_prev-56.24)/24.77),5) + 5*(1/24.77)*0.00225*pow(((x_prev-56.24)/24.77),4) + 4*(1/24.77)*0.001846*pow(((x_prev-56.24)/24.77),3) + 3*(1/24.77)*(-0.005562)*pow(((x_prev-56.24)/24.77),2) + 2*(1/24.77)*(-0.0002777)*((x_prev-56.24)/24.77) + (1/24.77)*0.006952;
    }  
    
    C = C2-C1*corrente;
    //-------------------------------------------------------------------------------------------------------------------
    y_prevB = ocv - R_in*corrente; //Tensão terminal estimada a partir do SOC prévio
                
    P_prevB = 1*P_0B*1+Q; //Covariância do erro na estimativa a priori do estado
    
    L = (P_prevB*C)/(C*P_prevB*C+R); //Ganho de Kalman

    //Atualização do estado estimado   
    x_posB = x_prevB + ((P_prevB*C)/(C*P_prevB*C+R))*(v_0 - y_prevB);

    //Alteração proposta B: 
    //Se a tensão estimada desviar da medida, atualização do SOC é desconsiderada
    if((corrente>0)&&(abs(v_0-y_prevB)>0.005))
    {
      x_posB = x_prevB;
      ref = 3; //Indica que o SOC EKF está sendo alerado pela proposta B
    }

    if(x_posB>100)
      {
        x_posB = 100;
      }

    if(x_posB<0)
      {
        x_posB = 0;
      }

    //Atualização da covariância do erro de estimativa
    P_0B = (1-L*C)*P_prevB*(1-L*C)+L*R*L;
       
    //Cálcula intervalo de confiança e adiciona à estimativa EKF 
    x_posmxB = x_posB + 10*sqrt(P_0B);
    x_posmiB = x_posB - 10*sqrt(P_0B);  
    
    //Atualiza SOC inicial para próximo passo 
    x_0B = x_posB;
}

//Função para estimativa SOC via contagem de Coulomb na Carga
void Coulomb_carga(){
     ref = 0;
     t_end = millis();
     //Atualiza variáveis do SOC: EKF Proposta A/B, contagem de Coulomb
     x_posA = x_0A - 1*((abs(t_end - t_0)+abs(t_0 - t_end1))/3.6e06)*(corrente/38)*100;
     x_posB = x_0B - 1*((abs(t_end - t_0)+abs(t_0 - t_end1))/3.6e06)*(corrente/38)*100;
     x_cc = x_cc - 1*((abs(t_end - t_0)+abs(t_0 - t_end1))/3.6e06)*(corrente/38)*100;

     if(st==1)  //Redefine parâmetros após descarga/repouso
     {
       DODc = 0; //Capacidade de carga reiniciada após processo de descarga (st==1)
       st=0;  //Carrega informação do processo atual de descarga
       estado = 0; //Indica carga incompleta
     }

     //Cálculo de Ah carregado
     DODc = DODc + ((abs(t_end - t_0)+abs(t_0 - t_end1))/3.6e06)*corrente;
     t_end1 = millis();

     //Verifica se a condição de bateria carregada foi alcançada
     if((v_0>=2.62)&&(v_0<=2.72)&&(abs(corrente)<=0.8))
     {
       //Atualiza variáveis
       x_posA = 100;
       x_posB = 100;
       x_cc = 100;
       estado = 1;
     }

     if(x_posA>100)
     {
      x_posA = 100;
     }
     
     x_0A = x_posA;

     if(x_posB>100)
     {
      x_posB = 100;
     }
     
     x_0B = x_posB;
}
